mTwardowski020/CAM-CAD-EDA-PROJEKT-/!dokumentacja!/3D.JPG

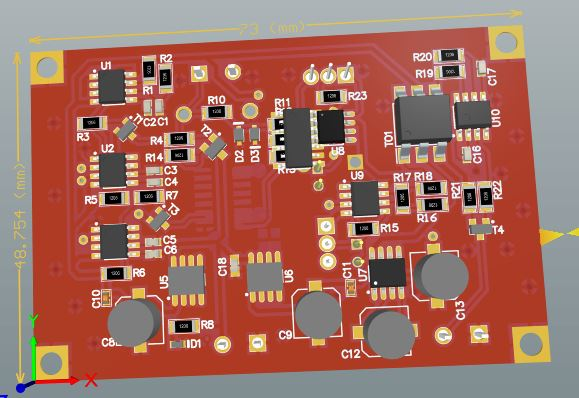
!dokumentacja!/3D.JPG
