mTwardowski020/CAM-CAD-EDA-PROJEKT-/!dokumentacja!/pola_lutownicze_zaprojektowane.JPG

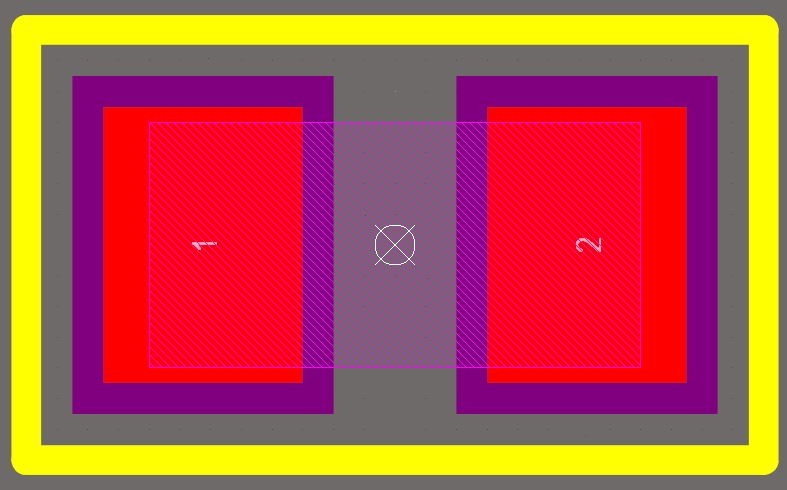
!dokumentacja!/pola_lutownicze_zaprojektowane.JPG
