mTwardowski020/CAM-CAD-EDA-PROJEKT-/MetalDetector/ICL7660SCBA.PNG

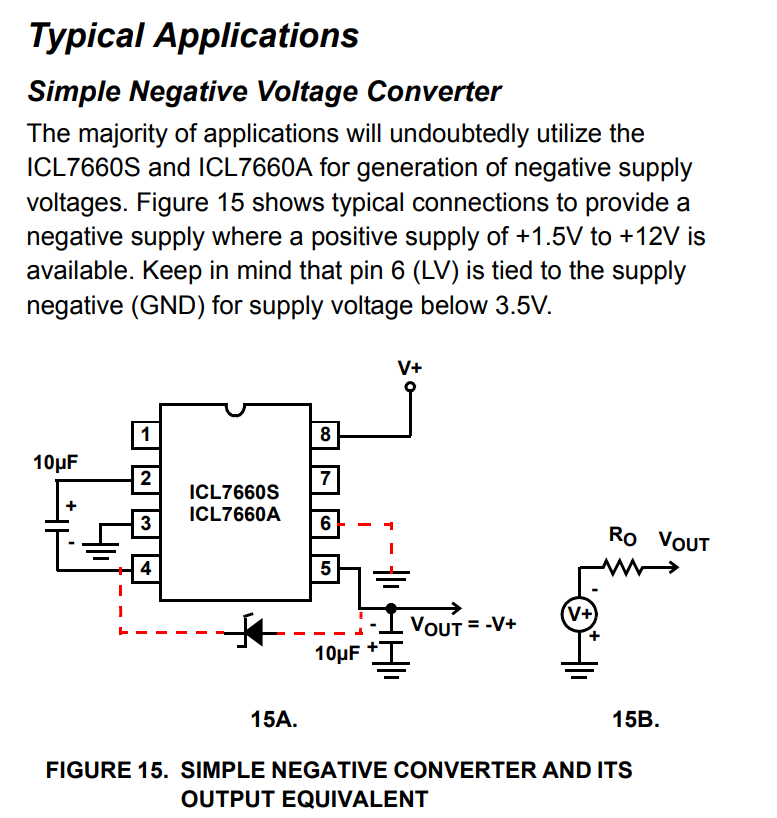
MetalDetector/ICL7660SCBA.PNG
