mTwardowski020/CAM-CAD-EDA-PROJEKT-/MetalDetector/L78L05.PNG

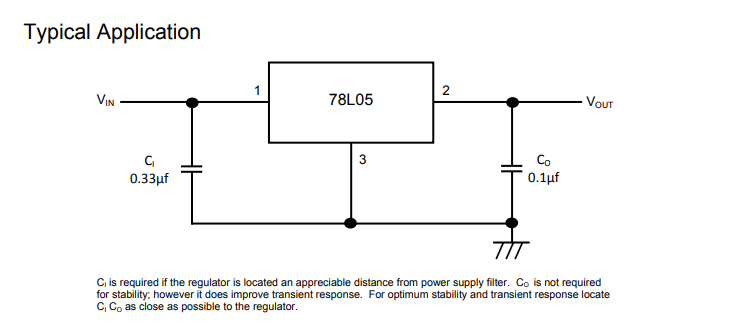
MetalDetector/L78L05.PNG
