mTwardowski020/CAM-CAD-EDA-PROJEKT-/MetalDetector/LED Parameters.PNG

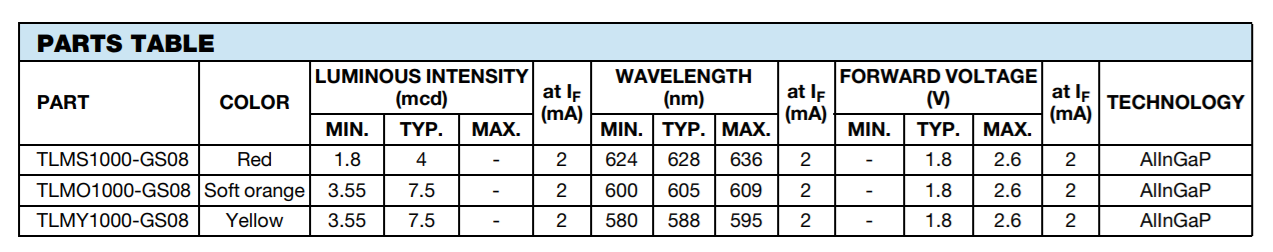
MetalDetector/LED Parameters.PNG
