mTwardowski020/CAM-CAD-EDA-PROJEKT-/MetalDetector/LED_R_KALK.PNG

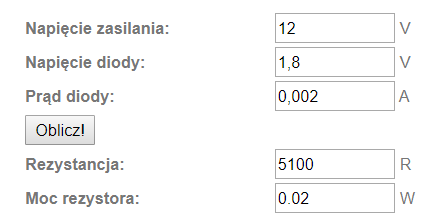
MetalDetector/LED_R_KALK.PNG
