mTwardowski020/CAM-CAD-EDA-PROJEKT-/MetalDetector/NE555_Astabilny.PNG

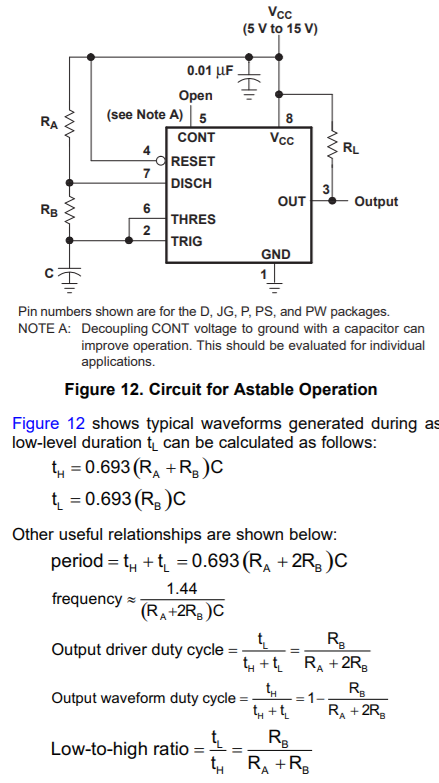
MetalDetector/NE555_Astabilny.PNG
