mTwardowski020/CAM-CAD-EDA-PROJEKT-/MetalDetector/NE555_Licznik1.PNG

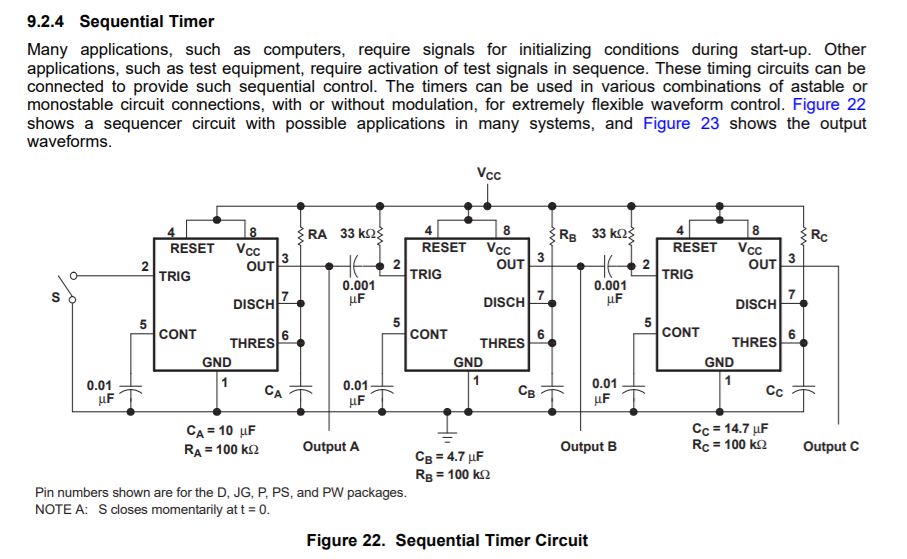
MetalDetector/NE555_Licznik1.PNG
