mTwardowski020/CAM-CAD-EDA-PROJEKT-/schemat.JPG

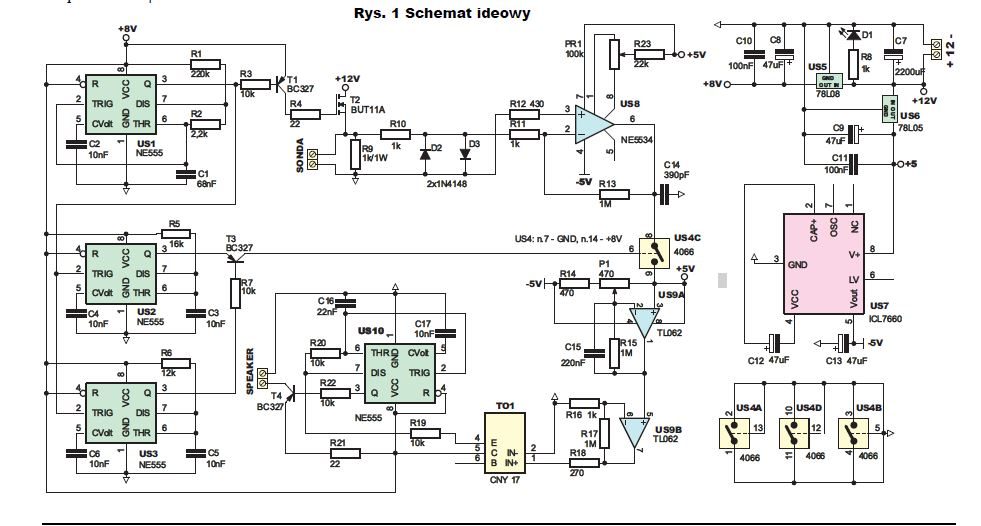
schemat.JPG
