mTwardowski020/CAM-CAD-EDA-PROJEKT-/BOM.xlsx

Sheet: Bałagan
ID | Wartosc | Uwagi | Kod producenta | Link | library
C1 | 68nF | nie może być MLCC bo pogarsza | VJ0603Y683KXJCW1BC
C10 | 100nF |  | CL10B104KA8NNNC | https://www.tme.eu/pl/details/cl10b104ka8nnnc/kondensatory-mlcc-smd-0603/samsung/ | null
C11 | 100nF |  | CL10B104KA8NNNC | https://www.tme.eu/pl/details/cl10b104ka8nnnc/kondensatory-mlcc-smd-0603/samsung/ | null
C12 | 10uF | 25V | UUD1E470MCL1GS | https://www.digikey.com/product-detail/en/nichicon/UUD1E470MCL1GS/493-2273-2-ND/590014 | yes
C13 | 10uF | 25V | UUD1E470MCL1GS | https://www.digikey.com/product-detail/en/nichicon/UUD1E470MCL1GS/493-2273-2-ND/590014 | yes
C14 | 470pF | OK. | CC-470 | https://www.tme.eu/pl/details/cc-470/kondensatory-ceramiczne-tht-50v/sr-passives/ | null
C15 | 220nF | nie może być MLCC bo pogarsza |  | https://www.tme.eu/pl/details/cm-220n/kondensatory-mlcc-tht/sr-passives/ | null
C16 | 22nF | nie może być MLCC bo pogarsza |  | https://www.tme.eu/pl/details/cc-22n/kondensatory-ceramiczne-tht-50v/sr-passives/ | null
C18 | 330nF |  | 0603YD334KAT2A | https://www.tme.eu/pl/details/0603yd334kat2a/kondensatory-mlcc-smd-0603/avx/
C17 | 10nF | nie może być MLCC bo pogarsza |  | https://www.tme.eu/pl/details/cc-10n/kondensatory-ceramiczne-tht-50v/sr-passives/ | yes
C2 | 10nF | nie może być MLCC bo pogarsza | VJ0603Y103KNAAO |  | yes
C3 | 10nF | nie może być MLCC bo pogarsza | VJ0603Y103KNAAO |  | yes
C4 | 10nF | nie może być MLCC bo pogarsza | VJ0603Y103KNAAO |  | yes
C5 | 10nF | nie może być MLCC bo pogarsza | VJ0603Y103KNAAO |  | yes
C6 | 10nF | nie może być MLCC bo pogarsza | VJ0603Y103KNAAO |  | yes
C7 | 2200uF | 25V | KM 2200U/25V | https://www.tme.eu/pl/details/km2200_25/kondensatory-elektrolityczne-tht-105degc/samxon/km-2200u-25v/ | null
C8 | 47uF | 25V | UUD1E470MCL1GS | https://www.digikey.com/product-detail/en/nichicon/UUD1E470MCL1GS/493-2273-2-ND/590014
C9 | 47uF | 25V | UUD1E470MCL1GS | https://www.digikey.com/product-detail/en/nichicon/UUD1E470MCL1GS/493-2273-2-ND/590014
D1 | 0603 LED | może R8 wymienic na 560Ohm | TLMS1000-GS08 | https://www.tme.eu/pl/details/tlms1000-gs08/diody-led-smd-kolorowe/vishay/ | yes
D2 | 1N4148 |  | 1N4148WS | https://pl.mouser.com/ProductDetail/ON-Semiconductor-Fairchild/1N4148WS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 | null
D3 | 1N4148 |  | 1N4148WS | https://pl.mouser.com/ProductDetail/ON-Semiconductor-Fairchild/1N4148WS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 | null
PR2 | 470 | obrotowy/liniowy | T910W-50R | https://www.tme.eu/en/details/t910w-50r/3-8-inch-multiturn-tht-trimmers/sr-passives/ | null
P1 | 2 |  | 282836-2 | https://www.tme.eu/pl/details/282836-2/listwy-zaciskowe-do-druku/te-connectivity/
PR1 | 100k | wieloobrotowy | 3296W-1-104LF | https://www.tme.eu/en/details/3296w-1-104lf/3-8-inch-multiturn-tht-trimmers/bourns/ | null
R1 | 220k |  | 1206S4J0224T5E | https://www.tme.eu/pl/details/smd1206-220k/rezystory-smd-1206/royal-ohm/1206s4j0224t5e/ | null
R10 | 1k |  | 1206S4J0102T5E | https://www.tme.eu/pl/details/smd1206-1k/rezystory-smd-1206/royal-ohm/1206s4j0102t5e/ | null
R11 | 1k |  | 1206S4J0102T5E | https://www.tme.eu/pl/details/smd1206-1k/rezystory-smd-1206/royal-ohm/1206s4j0102t5e/ | null
R12 | 430 |  | 1206S4J0431T5E | https://www.tme.eu/pl/details/smd1206-430r/rezystory-smd-1206/royal-ohm/1206s4j0431t5e/ | null
R13 | 1M |  | 1206S4J0105T5E | https://www.tme.eu/pl/details/smd1206-1m/rezystory-smd-1206/royal-ohm/1206s4j0105t5e/ | null
R14 | 1k | Rozladowujacy bramke | 1206S4J0102T5E | https://www.tme.eu/pl/details/smd1206-1k/rezystory-smd-1206/royal-ohm/1206s4j0102t5e/ | null
R15 | 1M |  | 1206S4J0105T5E | https://www.tme.eu/pl/details/smd1206-1m/rezystory-smd-1206/royal-ohm/1206s4j0105t5e/ | null
R16 | 1k |  | 1206S4J0102T5E | https://www.tme.eu/pl/details/smd1206-1k/rezystory-smd-1206/royal-ohm/1206s4j0102t5e/ | null
R17 | 1M |  | 1206S4J0105T5E | https://www.tme.eu/pl/details/smd1206-1m/rezystory-smd-1206/royal-ohm/1206s4j0105t5e/ | null
R18 | 270 |  | 1206S4J0271T5E | https://www.tme.eu/pl/details/smd1206-270r/rezystory-smd-1206/royal-ohm/1206s4j0271t5e/ | null
R19 | 10k |  | 1206S4J0103T5E | https://www.tme.eu/pl/details/smd1206-10k/rezystory-smd-1206/royal-ohm/1206s4j0103t5e/ | null
R2 | 2,2k |  | 1206S4J0222T5E | https://www.tme.eu/pl/details/smd1206-2k2/rezystory-smd-1206/royal-ohm/1206s4j0222t5e/ | null
R20 | 10k |  | 1206S4J0103T5E | https://www.tme.eu/pl/details/smd1206-10k/rezystory-smd-1206/royal-ohm/1206s4j0103t5e/ | null
R21 | 22 |  | 1206S4J0220T5E | https://www.tme.eu/pl/details/smd1206-22r/rezystory-smd-1206/royal-ohm/1206s4j0220t5e/ | null
R22 | 10k |  | 1206S4J0103T5E | https://www.tme.eu/pl/details/smd1206-10k/rezystory-smd-1206/royal-ohm/1206s4j0103t5e/ | null
R23 | 22k |  | RC1206FR-0722KL | https://www.tme.eu/pl/details/rc1206fr-0722k/rezystory-smd-1206/yageo/rc1206fr-0722kl/ | yes
R3 | 10k |  | 1206S4J0103T5E | https://www.tme.eu/pl/details/smd1206-10k/rezystory-smd-1206/royal-ohm/1206s4j0103t5e/ | null
R4 | 22 |  | 1206S4J0220T5E | https://www.tme.eu/pl/details/smd1206-22r/rezystory-smd-1206/royal-ohm/1206s4j0220t5e/ | null
R5 | 16k |  | 1206S4J0163T5E | https://www.tme.eu/pl/details/smd1206-16k/rezystory-smd-1206/royal-ohm/1206s4j0163t5e/ | null
R6 | 12k |  | 1206S4J0123T5E | https://www.tme.eu/pl/details/smd1206-12k/rezystory-smd-1206/royal-ohm/1206s4j0123t5e/ | null
R7 | 10k |  | 1206S4J0103T5E | https://www.tme.eu/pl/details/smd1206-10k/rezystory-smd-1206/royal-ohm/1206s4j0103t5e/ | null
R8 | 5,1k |  | 1206S4J0512T5E | https://www.tme.eu/pl/details/smd1206-5k1/rezystory-smd-1206/royal-ohm/1206s4j0512t5e/ | null
R9 | 1k | 0,5W Obudowa(2010) | CRS2010AFX-1001ELF | https://pl.mouser.com/ProductDetail/Bourns/CRS2010AFX-1001ELF | yes
Speaker | 8Ohm | 0,5W ||| ? | LD-SP-2908 | https://www.tme.eu/pl/details/ld-sp-2908/glosniki/loudity/
T1 | BC 327 |  | BC807-16-DIO | https://www.tme.eu/pl/details/bc807-16-dio/tranzystory-pnp-smd/diotec-semiconductor/bc807-16/ | null
T2 | IRF740 | ? | TN2540N8-G | https://www.tme.eu/pl/details/tn2540n8-g/tranzystory-z-kanalem-n-smd/microchip-supertex/ | yes
T3 | BC 327 |  | BC807-16-DIO | https://www.tme.eu/pl/details/bc807-16-dio/tranzystory-pnp-smd/diotec-semiconductor/bc807-16/ | null
T4 | BC 327 |  | BC807-16-DIO | https://www.tme.eu/pl/details/bc807-16-dio/tranzystory-pnp-smd/diotec-semiconductor/bc807-16/ | null
TO1 | CNY-17 |  | CNY17-1S | https://www.tme.eu/pl/details/cny17-1s/transoptory-wyjscie-analogowe/liteon/ | null
US1 | NE 555 | ? | NE555DR | https://www.digikey.com/product-detail/en/NE555DR/296-6501-1-ND/372490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 | yes
US10 | NE 555 |  | NE555DR | https://www.digikey.com/product-detail/en/NE555DR/296-6501-1-ND/372490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 | yes
US2 | NE 555 |  | NE555DR | https://www.digikey.com/product-detail/en/NE555DR/296-6501-1-ND/372490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 | yes
US3 | NE 555 |  | NE555DR | https://www.digikey.com/product-detail/en/NE555DR/296-6501-1-ND/372490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 | yes
US4 | 4066 | ? | CD4066BM96 | https://pl.mouser.com/ProductDetail/Texas-Instruments/CD4066BM96 | null
US5 | 78L08 |  | L78L08ACD13TR | https://www.tme.eu/pl/details/l78l08acd13tr/stabilizatory-napiecia-nieregulowane/stmicroelectronics/ | yes
US6 | 78L05 |  | L78L05ABD13TR | https://www.tme.eu/pl/details/l78l05abd13tr/stabilizatory-napiecia-nieregulowane/stmicroelectronics/ | yes
US7 | ICL 7660 |  | ICL7660SCBAZ-T | https://www.tme.eu/pl/details/icl7660scbaz-t/regulatory-napiecia-uklady-dc-dc/renesas-intersil/ | null
US8 | NE5534 |  | NE5534DR | https://pl.mouser.com/ProductDetail/Texas-Instruments/NE5534DR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 | yes
US9 | TL062 |  | AP4310AMTR-G1 | https://www.tme.eu/pl/details/ap4310amtr-g1/wzmacniacze-operacyjne-smd/diodes-incorporated/ | null

Sheet: Porządek
1_ZASILANIE
Desygnator | Wartosc | Uwagi | Kod producenta | Link | Footprint | Status
P1 | Nie dotyczy | Female Header, Pitch 5 mm, 1 x 2 Position, Height 10 mm, Tail Length 3.5 mm, Rohs, Bulk | 282836-2@TME | https://www.tme.eu/pl/details/282836-2/listwy-zaciskowe-do-druku/te-connectivity/ | Altium Vault (CMP-1684-00017-1) | OK.
C7 | 2200 uF | THT; 2200uF; 25VDC; Ø12,5x20mm; ±20% | KM 2200U/25V@TME | https://www.tme.eu/pl/details/km2200_25/kondensatory-elektrolityczne-tht-105degc/samxon/km-2200u-25v/ | MT_Library (Cap Electrolytic)
R8 | 5,1k | SMD; 1206; 5,1kΩ; 0,25W; ±5%; -55÷125°C | 1206S4J0512T5E@TME | https://www.tme.eu/pl/details/smd1206-5k1/rezystory-smd-1206/royal-ohm/1206s4j0512t5e/ | MT_Library (Res) (R1206) | OK.
D1 | Nie dotyczy | LED; SMD; 0603; czerwony; 1,8÷4mcd; 1,6x0,8x0,6mm; 80°; 1,8÷2,6V | TLMS1000-GS08 | https://www.tme.eu/pl/details/tlms1000-gs08/diody-led-smd-kolorowe/vishay/ | Altium Vault (CMP-2000-07254-1) | OK.
U5 | Nie dotyczy | Stabilizator napięcia; liniowy,nieregulowany; 8V; 0,1A; SO8; SMD | L78L08ACD13TR@TME | https://www.tme.eu/pl/details/l78l08acd13tr/stabilizatory-napiecia-nieregulowane/stmicroelectronics/ | Altium Vault (CMP-0244-00234-1) | OK.
C8 | 47 uF | Aluminum Electrolytic Capacitor, UD Series, Low Impedance, 47 uF, 25 V, + / - 20%, -55 to 105 degC, Chip Type, 6.3 x 5.8 mm D x L, Pb-Free, Reel | UUD1E470MCL1GS |  | Altium Vault (CMP-0687-00039-1) | OK.
C10 | 100 nF | ceramiczny; MLCC; 100nF; 25V; X7R; ±10%; SMD; 0603 | CL10B104KA8NNNC@TME | https://www.tme.eu/pl/details/cl10b104ka8nnnc/kondensatory-mlcc-smd-0603/samsung/ | MT_Library (Cap) (0603) | OK.
C12 | 47 uF | Aluminum Electrolytic Capacitor, UD Series, Low Impedance, 47 uF, 25 V, + / - 20%, -55 to 105 degC, Chip Type, 6.3 x 5.8 mm D x L, Pb-Free, Reel | UUD1E470MCL1GS |  | Altium Vault (CMP-0687-00039-1) | OK.
U7 | Nie dotyczy | Charge Pump Switching Regulator IC Positive or Negative Fixed, 1.5 to 12 V, 0 to 70 degC, RoHS, Tube | ICL7660SCBA |  | Altium Vault (CMP-2000-06437-1) | OK.
C13 | 47 uF | Aluminum Electrolytic Capacitor, UD Series, Low Impedance, 47 uF, 25 V, + / - 20%, -55 to 105 degC, Chip Type, 6.3 x 5.8 mm D x L, Pb-Free, Reel | UUD1E470MCL1GS |  | Altium Vault (CMP-0687-00039-1) | OK.
C18 | 330 nF |  | 0603YD334KAT2A |  | Altium Vault (CMP-2006-04538-1) można również zastosować MT_Library (Cap) (0603) | OK.
U6 | Nie dotyczy | Positive Voltage Regulator, 5V, 8-Pin SO, Tape and Reel | L78L05ABD13TR@TME | https://www.tme.eu/pl/details/l78l05abd13tr/stabilizatory-napiecia-nieregulowane/stmicroelectronics/ | Altium Vault (CMP-0244-00242-1) | OK.
C9 | 47 uF | Aluminum Electrolytic Capacitor, UD Series, Low Impedance, 47 uF, 25 V, + / - 20%, -55 to 105 degC, Chip Type, 6.3 x 5.8 mm D x L, Pb-Free, Reel | UUD1E470MCL1GS |  | Altium Vault (CMP-0687-00039-1) | OK.
C11 | 100 nF | ceramiczny; MLCC; 100nF; 25V; X7R; ±10%; SMD; 0603 | CL10B104KA8NNNC@TME | https://www.tme.eu/pl/details/cl10b104ka8nnnc/kondensatory-mlcc-smd-0603/samsung/ | MT_Library (Cap) (0603) | OK.
2_Astabilny Generator Sygnału
Desygnator | Wartosc | Uwagi | Kod producenta | Link | Footprint | Status
C2 | 10 nF |  | VJ0603Y103KNAAO |  | Altium Vault (CMP-2006-01968-1) można również zastosować MT_Library (Cap) (0603) | OK.
U1 | Nie dotyczy | Precision Timer, 4.5 to 16 V, 0 to 70 degC, 8-Pin SOIC (D), Green (RoHS & no Sb/Br), Tube | NE555D |  | Altium Vault (NE555) | OK.
C1 | 68 nF |  | VJ0603Y683KXJCW1BC |  | Altium Vault (CMP-2006-01832-1) | OK.
R1 | 220k |  | 1206S4J0224T5E@TME |  | MT_Library (Res) (R1206) | OK.
R2 | 2,2k |  | 1206S4J0222T5E@TME |  | MT_Library (Res) (R1206) | OK.
R3 | 10k |  | 1206S4J0103T5E@TME |  | MT_Library (Res) (R1206) | OK.
T1 | Nie dotyczy | General Purpose Transistor, PNP Silicon, 3-Pin SOT-23, Pb-Free, Tape and Reel | BC807-25LT1G |  | Altium Vault (CMP-1048-00691-1) | OK.
R4 | 22 |  | 1206S4J0220T5E@TME |  | MT_Library (Res) (R1206) | OK.
R14 | 1k | Rozładowujący bramke | 1206S4J0102T5E@TME | https://www.tme.eu/pl/details/smd1206-1k/rezystory-smd-1206/royal-ohm/1206s4j0102t5e/ | MT_Library (Res) (R1206) | OK.
T2 | Nie dotyczy | N-Channel Enhancement-Mode Vertical DMOS FET, 2 V, 1 A, 12 Ohm, -55 to 150 degC, 3-Pin SOT-89, RoHS, Tape and Reel | TN2540N8-G |  | Altium Vault (CMP-2000-07270-1) | OK.
3_Sterowanie kluczem
Desygnator | Wartosc | Uwagi | Kod producenta | Link | Footprint | Status
U2 | Nie dotyczy | Precision Timer, 4.5 to 16 V, 0 to 70 degC, 8-Pin SOIC (D), Green (RoHS & no Sb/Br), Tube | NE555D |  | Altium Vault (NE555) | OK.
U3 | Nie dotyczy | Precision Timer, 4.5 to 16 V, 0 to 70 degC, 8-Pin SOIC (D), Green (RoHS & no Sb/Br), Tube | NE555D |  | Altium Vault (NE555) | OK.
C4 | 10 nF |  | VJ0603Y103KNAAO |  | Altium Vault (CMP-2006-01968-1) można również zastosować MT_Library (Cap) (0603) | OK.
C6 | 10 nF |  | VJ0603Y103KNAAO |  | Altium Vault (CMP-2006-01968-1) można również zastosować MT_Library (Cap) (0603) | OK.
C3 | 10 nF |  | VJ0603Y103KNAAO |  | Altium Vault (CMP-2006-01968-1) można również zastosować MT_Library (Cap) (0603) | OK.
C5 | 10 nF |  | VJ0603Y103KNAAO |  | Altium Vault (CMP-2006-01968-1) można również zastosować MT_Library (Cap) (0603) | OK.
R5 | 16k |  | 1206S4J0163T5E@TME |  | MT_Library (Res) (R1206) | OK.
R6 | 12k |  | 1206S4J0123T5E@TME |  | MT_Library (Res) (R1206) | OK.
T3 | Nie dotyczy | General Purpose Transistor, PNP Silicon, 3-Pin SOT-23, Pb-Free, Tape and Reel | BC807-25LT1G |  | Altium Vault (CMP-1048-00691-1) | OK.
R7 | 10k |  | 1206S4J0103T5E@TME |  | MT_Library (Res) (R1206) | OK.
U4 | Nie dotyczy | CMOS Quad Bilateral Switch, D0014A, LARGE T&R | CD4066BM96 |  | Altium Vault (CMP-1574-00003-3) | OK.
4_Sonda + wzmacniacz
Desygnator | Wartosc | Uwagi | Kod producenta | Link | Footprint | Status
P2 | Nie dotyczy | Female Header, Pitch 5 mm, 1 x 2 Position, Height 10 mm, Tail Length 3.5 mm, Rohs, Bulk | 282836-2@TME | https://www.tme.eu/pl/details/282836-2/listwy-zaciskowe-do-druku/te-connectivity/ | Altium Vault (CMP-1684-00017-1) | OK.
R9 | 1k | 1W THT | DO ZNALEZIENIA | DO ZNALEZIENIA | Altium Vault (CMP-2000-06865-1)
R10 | 1k |  | 1206S4J0102T5E@TME |  | MT_Library (Res) (R1206) | OK.
D2 | Nie dotyczy | Fast Switching Diode, 75 V, 0.3 A, -65 to 150 degC, 2-Pin SOD323, RoHS, Tape and Reel | 1N4148WS-7-F |  | Altium Vault (CMP-1667-00004-1) | OK.
D3 | Nie dotyczy | Fast Switching Diode, 75 V, 0.3 A, -65 to 150 degC, 2-Pin SOD323, RoHS, Tape and Reel | 1N4148WS-7-F |  | Altium Vault (CMP-1667-00004-1) | OK.
R11 | 1k |  | 1206S4J0102T5E@TME |  | MT_Library (Res) (R1206) | OK.
R12 | 430 |  | 1206S4J0102T5E@TME |  | MT_Library (Res) (R1206) | OK.
U8 | Nie dotyczy |  | NE5534 |  | MT_Library (NE5534)
PR1 | 100k | Square Trimpot(R) Trimming Potentiometer, 10 KOhm, +/- 10%, 0.5 W, -55 to 125 degC, 3-Pin THD, RoHS, Tube | 3296W-1-104LF@TME |  | Altium Vault (CMP-1747-00001-1) | OK.
R23 | 1k |  | 1206S4J0102T5E@TME |  | MT_Library (Res) (R1206) | OK.
R13 | 1k |  | 1206S4J0102T5E@TME |  | MT_Library (Res) (R1206) | OK.
C14 | 470 pF | Raster wyprowadzeń 2.54mm | CC-470@TME |  | Altium Vault (CMP-1664-00008-1) | OK.
5_Wzmacniacz + integrator
Desygnator | Wartosc | Uwagi | Kod producenta | Link | Footprint | Status
PR2 | 470 | Square Trimpot(R) Trimming Potentiometer, 10 KOhm, +/- 10%, 0.5 W, -55 to 125 degC, 3-Pin THD, RoHS, Tube | T910W-50R@TME |  | Altium Vault (CMP-1747-00001-1) | OK.
U9 | Nie dotyczy | Dual Low-Power JFET-Input General-Purpose Operational Amplifier, 7 to 36 V, 0 to 70 degC, 8-pin SOIC (D8), Green (RoHS & no Sb/Br) | TL062CDR |  | Altium Vault (CMP-0017-00600-2) | OK.
R15 | 1M |  | 1206S4J0105T5E@TME |  | MT_Library (Res) (1206) | OK.
C15 | 220 nF |  | CM-220N@TME |  | Altium Vault (CMP-1664-00008-1) | OK.
R17 | 1M |  | 1206S4J0105T5E@TME |  | MT_Library (Res) (1206) | OK.
R16 | 1k |  | 1206S4J0102T5E@TME |  | MT_Library (Res) (1206) | OK.
R18 | 270 |  | 1206S4J0271T5E@TME |  | MT_Library (Res) (1206) | OK.
5_Glosnik
Desygnator | Wartosc | Uwagi | Kod producenta | Link | Footprint | Status
