mTwardowski020/CAM-CAD-EDA-PROJEKT-/library_octopart/Res_Yageo_RC1206FR-0722KL/db.xlsx

Library Ref | Library Path | Footprint Ref | Footprint Path | Footprint Ref 2 | Footprint Path 2 | Footprint Ref 3 | Footprint Path 3 | Footprint Ref 4 | Footprint Path 4 | Datasheet Path | Capacitance | ComponentLink1Description | ComponentLink1URL | ComponentLink2Description | ComponentLink2URL | Composition | Datasheet Path | Description | Digikey Description | Digikey Part Number | Footprint Path | Footprint Path 2 | Footprint Path 3 | Footprint Path 4 | Footprint Ref | Footprint Ref 2 | Footprint Ref 3 | Footprint Ref 4 | Height | Inductance | Ipc Land Pattern Name | Lead Free | Library Path | Library Ref | Manufacturer | Mouser Description | Mouser Part Number | Package | Part Number | Power Rating | Price | Resistance | RoHS | Series | Supplier 1 | Supplier 2 | Supplier Part Number 1 | Supplier Part Number 2 | Temperature | Temperature Coefficient | Temperature Range High | Temperature Range Low | Tolerance | Value | Verification Version | Voltage | Voltage Rating | helpURL
RC1206FR-0722KL | parts/Res_Yageo_RC1206FR-0722KL_eec.SchLib | Yageo_RC1206_MFG | parts/Res_Yageo_RC1206FR-0722KL_eec_MFG.PcbLib | Yageo_RC1206_IPC_A | parts/Res_Yageo_RC1206FR-0722KL_eec_IPC_A.PcbLib | Yageo_RC1206_IPC_B | parts/Res_Yageo_RC1206FR-0722KL_eec_IPC_B.PcbLib | Yageo_RC1206_IPC_C | parts/Res_Yageo_RC1206FR-0722KL_eec_IPC_C.PcbLib | datasheets/Res_Yageo_RC1206FR-0722KL_eec.pdf | SKIP | Upverter | https://upverter.com/upn/revision/46e0c92fe315ef63/ | Datasheet | http://www.yageo.com/documents/recent/PYu-RC_Group_51_RoHS_L_9.pdf | Thick Film | datasheets/Res_Yageo_RC1206FR-0722KL_eec.pdf | RES SMD 22K OHM 1% 1/4W 1206 | RES SMD 22K OHM 1% 1/4W 1206 | 311-22.0KFRTR-ND | parts/Res_Yageo_RC1206FR-0722KL_eec_MFG.PcbLib | parts/Res_Yageo_RC1206FR-0722KL_eec_IPC_A.PcbLib | parts/Res_Yageo_RC1206FR-0722KL_eec_IPC_B.PcbLib | parts/Res_Yageo_RC1206FR-0722KL_eec_IPC_C.PcbLib | Yageo_RC1206_MFG | Yageo_RC1206_IPC_A | Yageo_RC1206_IPC_B | Yageo_RC1206_IPC_C | 0.6mm | SKIP | RESC320160X55 | yes | parts/Res_Yageo_RC1206FR-0722KL_eec.SchLib | RC1206FR-0722KL | Yageo | Thick Film Resistors 22K OHM 1% | 603-RC1206FR-0722KL | RC1206 | RC1206FR-0722KL | 0.25W | 0.013503906408 | 22kΩ | TRUE | RC | Digi-Key | Mouser | 311-22.0KFRTR-ND | 603-RC1206FR-0722KL | -55°C to +155°C | 100ppm/ºC | +155°C | -55°C | 1% | 22kΩ | 0.0.0.1 | SKIP | 200V | https://upverter.com/upn/revision/46e0c92fe315ef63/
