mTwardowski020/CAM-CAD-EDA-PROJEKT-/3D Models/User Library-so8-3.STEP

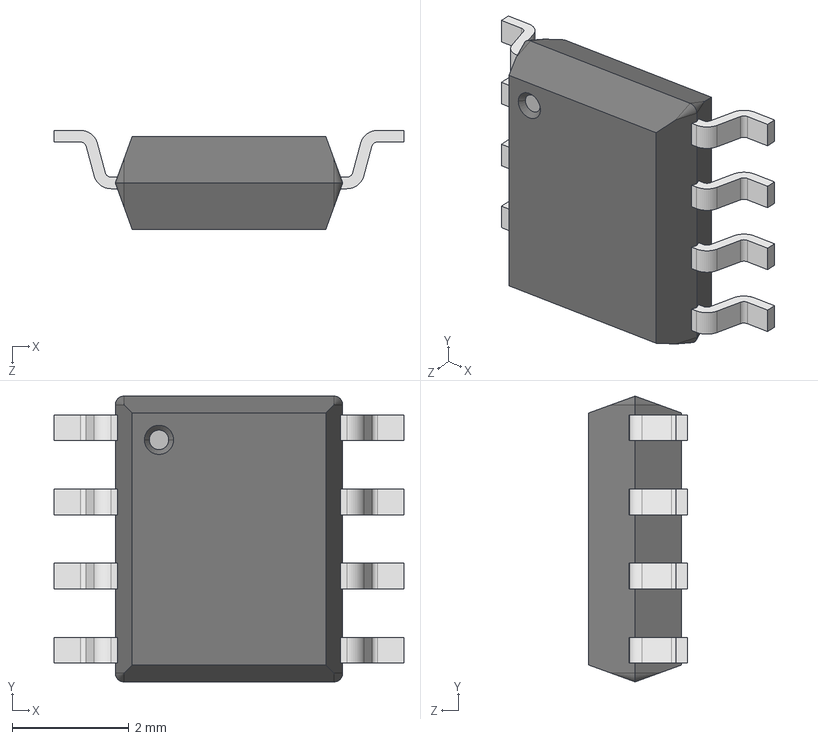
[picture p21: CAD file, 2019-12-14]
3D Models/User Library-so8-3.STEP
6.00 x 4.90 x 1.70 mm
