mTwardowski020/CAM-CAD-EDA-PROJEKT-/library_octopart/LIB_CNY17-3-300E/CNY17-3-300E/3D/CNY17-3-300E.stp

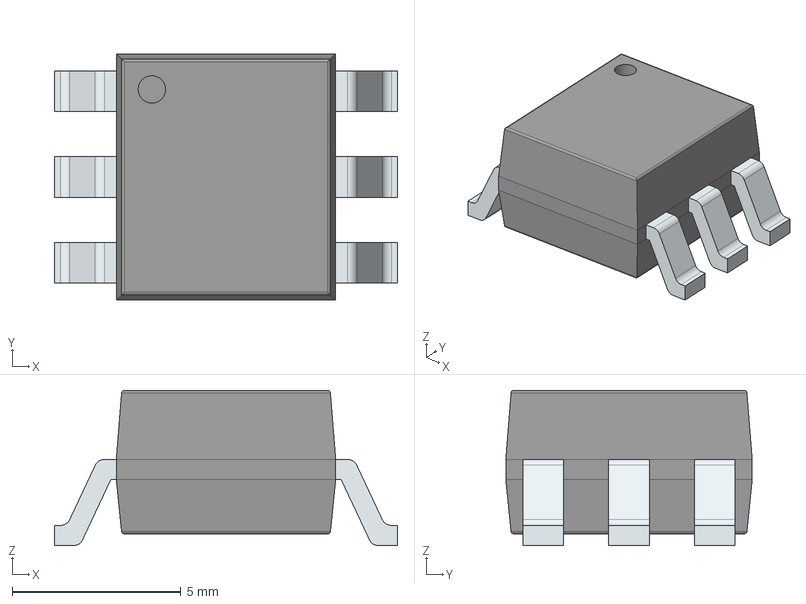
[picture p22: CAD file, 2019-11-22]
library_octopart/LIB_CNY17-3-300E/CNY17-3-300E/3D/CNY17-3-300E.stp
10.2 x 7.30 x 4.60 mm
PinsArrayLR
