mTwardowski020/CAM-CAD-EDA-PROJEKT-/library_octopart/Res_Yageo_RC1206FR-0722KL/parts/Res_Yageo_RC1206FR-0722KL_eec.STEP

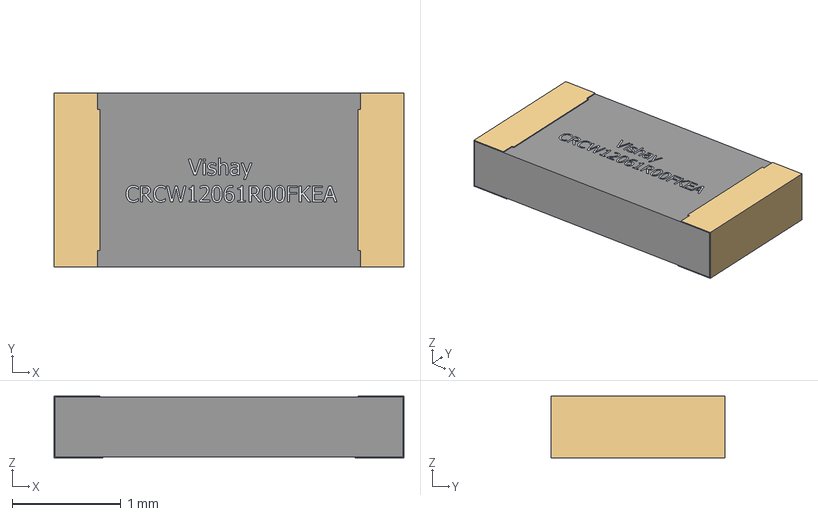
[picture p23: CAD file, 2019-10-23]
library_octopart/Res_Yageo_RC1206FR-0722KL/parts/Res_Yageo_RC1206FR-0722KL_eec.STEP
3.22 x 1.60 x 0.569 mm
