mTwardowski020/CAM-CAD-EDA-PROJEKT-/other libraries/CRS2010AFX-1001ELF.stp

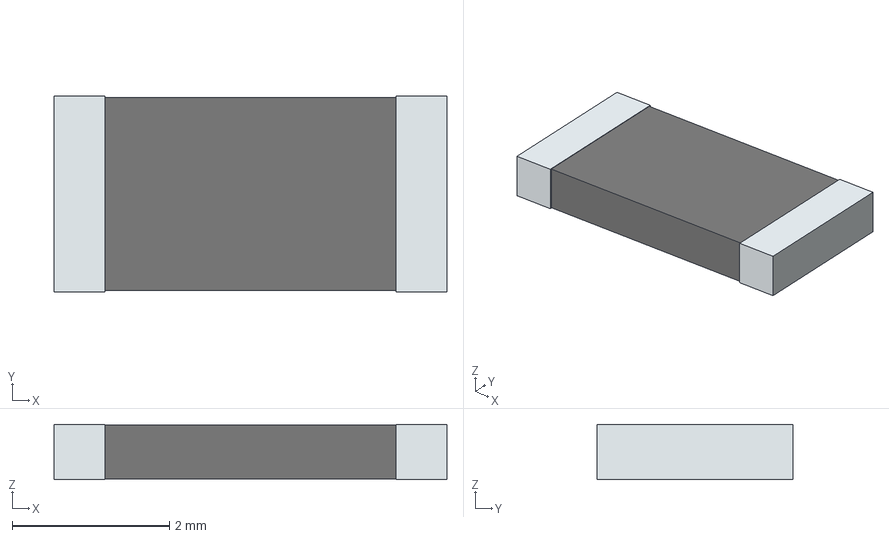
[picture p24: CAD file, 2019-10-23]
other libraries/CRS2010AFX-1001ELF.stp
5.00 x 2.50 x 0.7 mm
term1
term2
