mTwardowski020/CAM-CAD-EDA-PROJEKT-/3D Models/R_0603.step

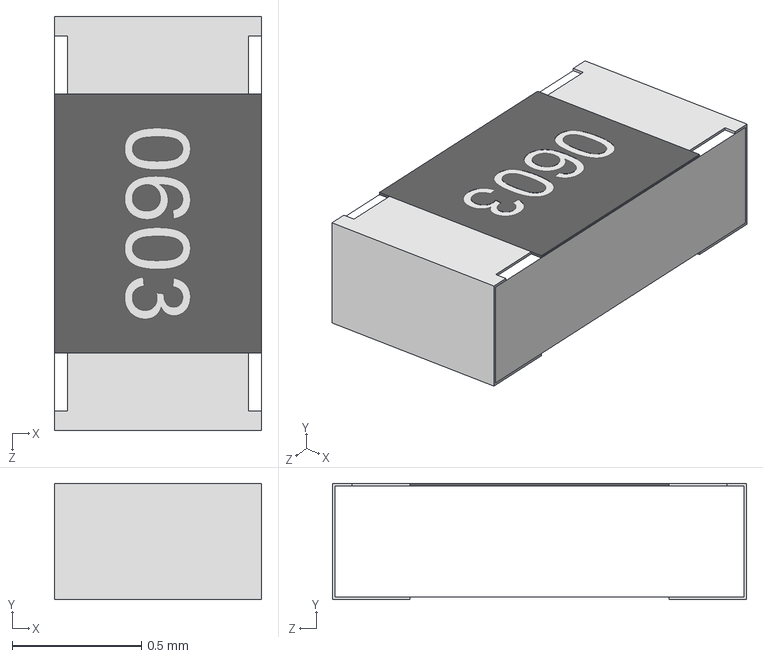
[picture p25: CAD file, 2019-10-24]
3D Models/R_0603.step
0.8 x 0.45 x 1.60 mm
