mTwardowski020/CAM-CAD-EDA-PROJEKT-/other libraries/0603YD334KAT2A.stp

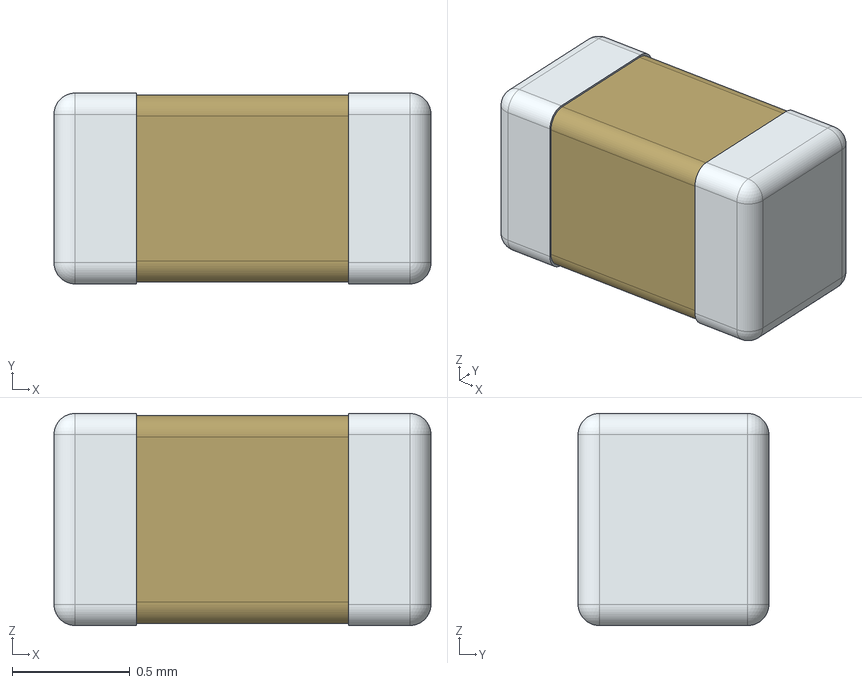
[picture p26: CAD file, 2019-10-23]
other libraries/0603YD334KAT2A.stp
1.60 x 0.81 x 0.9 mm
