mTwardowski020/CAM-CAD-EDA-PROJEKT-/3D Models/R_0201.step

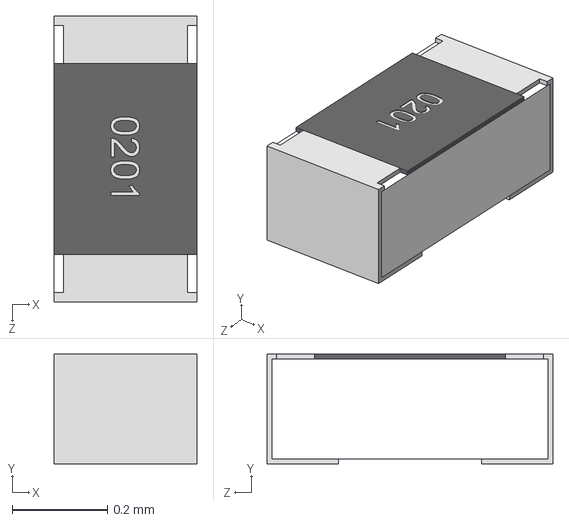
[picture p27: CAD file, 2019-10-24]
3D Models/R_0201.step
0.3 x 0.23 x 0.6 mm
