mTwardowski020/CAM-CAD-EDA-PROJEKT-/3D Models/R_0805.step

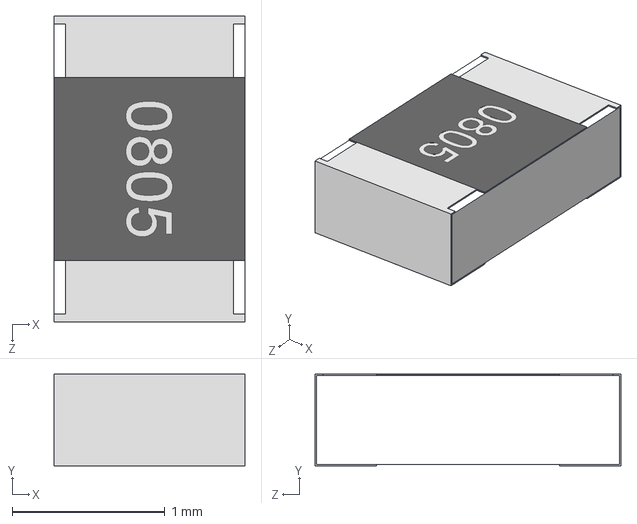
[picture p28: CAD file, 2019-10-24]
3D Models/R_0805.step
1.25 x 0.6 x 2.00 mm
