mTwardowski020/CAM-CAD-EDA-PROJEKT-/3D Models/R_0402.step

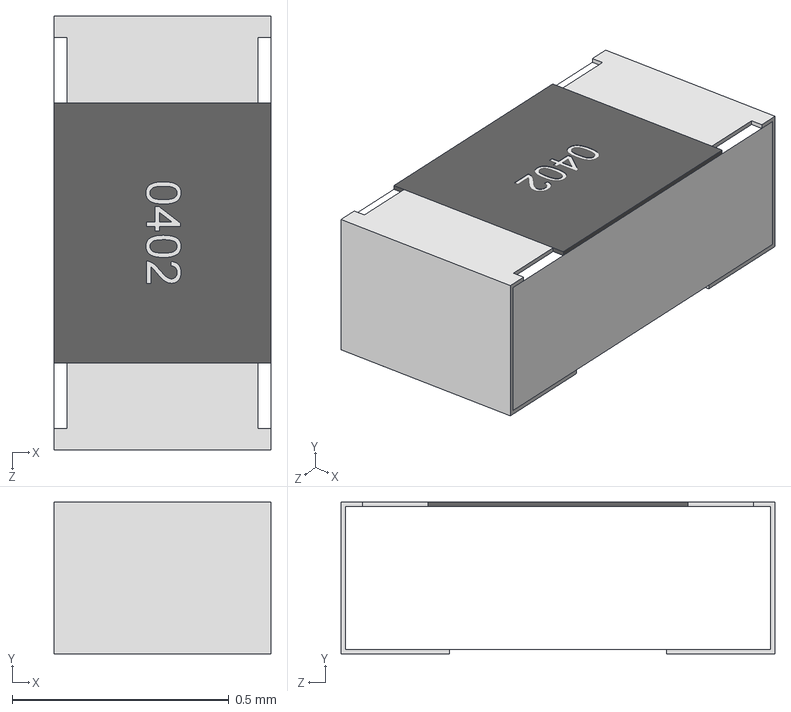
[picture p29: CAD file, 2019-10-24]
3D Models/R_0402.step
0.5 x 0.35 x 1.00 mm
