mTwardowski020/CAM-CAD-EDA-PROJEKT-/3D Models/C_0603.step

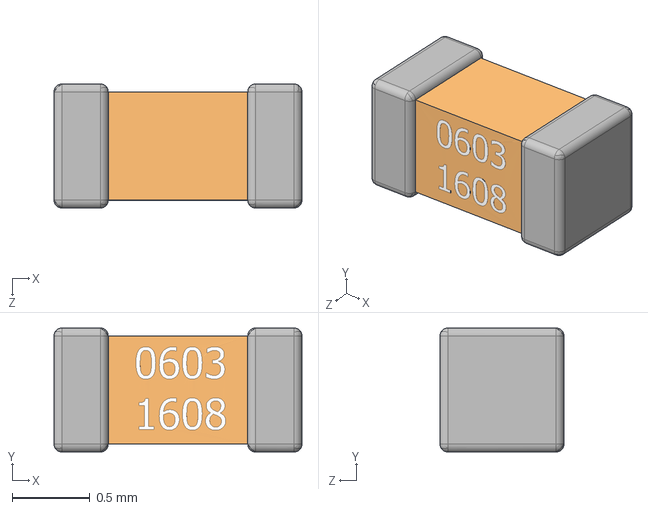
[picture p30: CAD file, 2019-10-23]
3D Models/C_0603.step
1.60 x 0.8 x 0.8 mm
