mTwardowski020/CAM-CAD-EDA-PROJEKT-/3D Models/R_1206.step

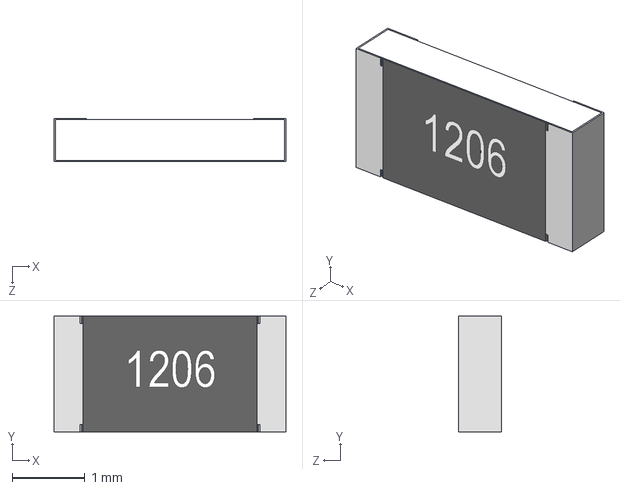
[picture p31: CAD file, 2019-10-23]
3D Models/R_1206.step
3.20 x 1.60 x 0.6 mm
