mTwardowski020/CAM-CAD-EDA-PROJEKT-/(list of files, cad)

Other CAD files:
library_octopart/LIB_CNY17-3-300E/CNY17-3-300E/3D/CNY17-3-300E.stl
library_octopart/LIB_CNY17-3-300E/CNY17-3-300E/Allegro/sop254p1016x460-6n.psm
library_octopart/LIB_CNY17-3-300E/CNY17-3-300E/DEHDL/cny17_3_300e/chips/chips.prt
other libraries/0603YD334KAT2A.stl
other libraries/CRS2010AFX-1001ELF.stl
