mTwardowski020/CAM-CAD-EDA-PROJEKT-/(list of files, drawings)

Other design files:
library_octopart/Cap_Panasonic_EEU-FC1V222SB/parts/Cap_Panasonic_EEU-FC1V222SB_eec.SchLib
library_octopart/Cap_Panasonic_EEU-FC1V222SB/parts/Cap_Panasonic_EEU-FC1V222SB_eec_0.PcbLib
library_octopart/CNY17-1X007T (1)/Imported PADS Libraries.PrjPcb/CNY17-1X007T.PcbLib
library_octopart/LIB_CNY17-3-300E/CNY17-3-300E/PADS/Imported PADS Libraries.PrjPcb/CNY17-3-300E.SchLib
library_octopart/LIB_CNY17-3-300E/CNY17-3-300E/PADS/Imported PADS Libraries.PrjPcb/PADS Libraries.PrjPcb
library_octopart/LIB_CNY17-3-300E/CNY17-3-300E/PADS/Imported PADS Libraries.PrjPcb/SOP254P1016X460-6N.PcbLib
library_octopart/NE555D/NE555D.PcbLib
library_octopart/NE555D/NE555D.SchLib
library_octopart/PCC-0170-00032-1/Released/TECO-282836-2_V.PcbLib
library_octopart/Res_Yageo_RC1206FR-0722KL/parts/Res_Yageo_RC1206FR-0722KL_eec.SchLib
library_octopart/Res_Yageo_RC1206FR-0722KL/parts/Res_Yageo_RC1206FR-0722KL_eec_IPC_A.PcbLib
library_octopart/Res_Yageo_RC1206FR-0722KL/parts/Res_Yageo_RC1206FR-0722KL_eec_IPC_B.PcbLib
library_octopart/Res_Yageo_RC1206FR-0722KL/parts/Res_Yageo_RC1206FR-0722KL_eec_IPC_C.PcbLib
library_octopart/Res_Yageo_RC1206FR-0722KL/parts/Res_Yageo_RC1206FR-0722KL_eec_MFG.PcbLib
library_octopart/SYM-0338-00001-1/Released/CN-1P-F-TB2.SchLib
MetalDetector/1_zasilanie.SchDoc
MetalDetector/2_astabilny generator sygnalu.SchDoc
MetalDetector/3_Sterowanie kluczem.SchDoc
MetalDetector/4_Sonda+wzmacniacz.SchDoc
MetalDetector/5_Wzmacniacz+Integrator.SchDoc
MetalDetector/6_Glosnik.SchDoc
MetalDetector/ascii files/1_zasilanie.SchDoc
MetalDetector/ascii files/1_zasilanie_ascii.SchDoc
MetalDetector/astabilny generator sygnalu.SchDoc
MetalDetector/Blokowy.SchDoc
MetalDetector/Capacitors_MT_Library.PcbLib
MetalDetector/MetalDetector.PrjPcb
MetalDetector/MetalDetector.SCHLIB
MetalDetector/NE5534_KW_Library.PcbLib
MetalDetector/PCB2.PcbDoc
MetalDetector/PCB2.PcbLib
MetalDetector/Resistors_MT_Library.PcbLib
MetalDetector/Sheet1.SchDoc
MetalDetector/Sonda+wzmacniacz.SchDoc
MetalDetector/Sterowanie kluczem.SchDoc
MetalDetector/zasilanie.SchDoc
