mTwardowski020/CAM-CAD-EDA-PROJEKT-/(commit log)

2019-10-06 1.0
    Utworzony plik schematic
    [MetalDetector.PrjPcb, Sheet1.SchDoc]
2019-10-06 1.01
    Dodanie instrukcji + wstepnego BOMa
    [WstepnyBOM.xlsx]
2019-10-06 Update WstepnyBOM.xlsx
    Dodane linki do elementów
    [WstepnyBOM.xlsx]
2019-10-16 1.02
    -Downloaded altium libraries
    -Started power schematic
    [zasilanie.SchDoc]
2019-10-16 commit from lesson
    add library from octopart page and update BOM
    [WstepnyBOM.xlsx]
2019-10-16 1.03
    TEST
    [zasilanie.SchDoc]
2019-10-16 1.04
    final BOM with libraries result
    [WstepnyBOM.xlsx]
2019-10-16 1.05
    our corrects
    [WstepnyBOM.xlsx]
2019-10-16 1.05b
    -Finished power section
    -Started Signal Generator section
    [astabilny generator sygnalu.SchDoc, zasilanie.SchDoc]
2019-10-19 1.06
    Modified BOM
    Added NE555 Schematic
    [MetalDetector.PrjPcb, Sterowanie kluczem.SchDoc, WstepnyBOM.xlsx, astabilny generator sygnalu.SchDoc, zasilanie.SchDoc]
2019-10-21 1.07
    Zmieniony BOM
    Dodane nowe schematy
    [MetalDetector.PrjPcb, Sonda+wzmacniacz.SchDoc, Sterowanie kluczem.SchDoc, WstepnyBOM.xlsx, astabilny generator sygnalu.SchDoc, zasilanie.SchDoc]
2019-10-23 1.07b
    Edytowany BOM
    [BOM.xlsx]
2019-10-23 1.07c
    new folder for libraries from mouser etc
    update BOM
    [BOM.xlsx, CRS2010AFX-1001ELF.stl, CRS2010AFX-1001ELF.stp]
2019-10-23 1.07d
    new libraries
    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
    [0603YD334KAT2A.stl, 0603YD334KAT2A.stp, BOM.xlsx]
2019-10-23 1.08
    Poprawione schematy
    [0603YD334KAT2A.stl, 0603YD334KAT2A.stp, CRS2010AFX-1001ELF.stl, CRS2010AFX-1001ELF.stp, MetalDetector.PrjPcb, Sheet1.SchDoc, Sonda+wzmacniacz.SchDoc, astabilny generator sygnalu.SchDoc]
2019-10-23 1.08b
    Dodana biblioteka rezystorow, kondensatorow.
    Znalezione footprinty i modele 3D do części schematu zasilania
    [C_0603.step, Cap_Panasonic_EEU-FC1V222SB_eec.SchLib, Cap_Panasonic_EEU-FC1V222SB_eec_0.PcbLib, Capacitors_MT_Library.PcbLib, R_1206.step, Res_Yageo_RC1206FR-0722KL_eec.STEP, Res_Yageo_RC1206FR-0722KL_eec.SchLib, Res_Yageo_RC1206FR-0722KL_eec_IPC_A.PcbLib]
2019-10-23 1.08c
    Drobne zmiany w BOMie
    Dodane zdjęcia z not katalogowych poszczególnych rozwiązań
    [BOM.xlsx, MetalDetector.PrjPcb, Sterowanie kluczem.SchDoc, astabilny generator sygnalu.SchDoc, zasilanie.SchDoc]
2019-10-24 1.09
    Zmiany w BOM
    Nowe modele 3D
    Nowe footprinty
    Kilka zmian w schematach
    [1_zasilanie.SchDoc, 2_astabilny generator sygnalu.SchDoc, 3_Sterowanie kluczem.SchDoc, 4_Sonda+wzmacniacz.SchDoc, BOM.xlsx, MetalDetector.PrjPcb, R_0201.step, R_0402.step]
2019-11-05 1.0.9a
    Zmiany BOM, zmiany schematu zasilania
    [1_zasilanie.SchDoc, 1_zasilanie_ascii.SchDoc, BOM.xlsx, MetalDetector.PrjPcb]
2019-11-16 1.10
    Nie pamietam szczerze mowiac co bo lezy od tygodnia bez commita
    [2_astabilny generator sygnalu.SchDoc, 3_Sterowanie kluczem.SchDoc, 4_Sonda+wzmacniacz.SchDoc, 5_Wzmacniacz+Integrator.SchDoc, 6_Glosnik.SchDoc, BOM.xlsx, MetalDetector.PrjPcb]
2019-11-21 1.11
    Drobne zmiany w schematach
    Przebudowany BOM
    [1_zasilanie.SchDoc, 2_astabilny generator sygnalu.SchDoc, 3_Sterowanie kluczem.SchDoc, 4_Sonda+wzmacniacz.SchDoc, 5_Wzmacniacz+Integrator.SchDoc, BOM.xlsx]
2019-11-21 1.12
    Zmodyfikowany BOM
    Uzupelniony schemat 5
    [1_zasilanie.SchDoc, 3_Sterowanie kluczem.SchDoc, 4_Sonda+wzmacniacz.SchDoc, 5_Wzmacniacz+Integrator.SchDoc, 6_Glosnik.SchDoc, BOM.xlsx, CNY17-1X007T.PcbLib]
2019-11-22 1.13
    Dokonczone wszystkie schematy (jeszcze do sprawdzenia)
    [2_astabilny generator sygnalu.SchDoc, 5_Wzmacniacz+Integrator.SchDoc, 6_Glosnik.SchDoc, BOM.xlsx, CN-1P-F-TB2.SchLib, CNY17-3-300E.SchLib, CNY17-3-300E.stl, CNY17-3-300E.stp]
2019-11-22 1.13.1
    Dodany schemat blokowy
    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
    [1_zasilanie.SchDoc, 2_astabilny generator sygnalu.SchDoc, 3_Sterowanie kluczem.SchDoc, 4_Sonda+wzmacniacz.SchDoc, 5_Wzmacniacz+Integrator.SchDoc, 6_Glosnik.SchDoc, Blokowy.SchDoc]
2019-11-22 1.13.2
    Drobne poprawki nazewnictwa
    [3_Sterowanie kluczem.SchDoc, 4_Sonda+wzmacniacz.SchDoc, 5_Wzmacniacz+Integrator.SchDoc, 6_Glosnik.SchDoc, Blokowy.SchDoc]
2019-11-24 1.13.3
    add footprint NE5534 (for check)
    [MetalDetector.PrjPcb, NE5534_KW_Library.PcbLib]
2019-11-25 1.13.4
    update created footprint (for check)
    [NE5534_KW_Library.PcbLib]
2019-12-13 1.14
    Poprawione footprinty
    TODO:
    Poprawic footprint NE5534 (za male pady)
    [2_astabilny generator sygnalu.SchDoc, 3_Sterowanie kluczem.SchDoc, 4_Sonda+wzmacniacz.SchDoc, 6_Glosnik.SchDoc, Blokowy.SchDoc, NE555D.PcbLib, NE555D.SchLib, PCB2.PcbDoc]
2019-12-14 1.14.1
    Poprawiony NE5534, dodany tez model 3D
    [NE5534_KW_Library.PcbLib, PCB2.PcbDoc, User Library-so8-3.STEP]
2019-12-15 1.15
    Wstępny zarys płytki
    [4_Sonda+wzmacniacz.SchDoc, 5_Wzmacniacz+Integrator.SchDoc, MetalDetector.PrjPcb, PCB2.PcbDoc]
2019-12-16 1.15.1
    Dlaczego nie działa autorouter..............................................
    [1_zasilanie.SchDoc, 5_Wzmacniacz+Integrator.SchDoc, Blokowy.SchDoc, MetalDetector.PrjPcb, MetalDetector.SCHLIB, PCB2.PcbDoc, PCB2.PcbLib]
2020-01-06 1.16
    Polowa plytki rozmieszczona tak jak trzeba
    [2_astabilny generator sygnalu.SchDoc, PCB2.PcbDoc]
2020-01-07 1.17
    Rozmieszczone elementy, trzeba dac sciezki
    [PCB2.PcbDoc]
2020-01-07 1.18
    Plytka gotowa v1
    [PCB2.PcbDoc]
2020-01-07 1.18.1
    Poprawione wszystko. Plytka gotowa
    [PCB2.PcbDoc]
2020-01-08 1.18.0001
    documentation + documentation screens
    [PCB2.GBL, PCB2.GTL]
2020-01-15 2.1
    PCB size
    [PCB2.PcbDoc]
